xw2519/EE-Mars-Rover/src/Control/Esp32_Client.ino

/*
    Esp32 Websockets Client

    This sketch:
        1. Connects to a WiFi network
        2. Connects to a Websockets server
        3. Sends the websockets server a message ("Hello Server")
        4. Prints all incoming messages while the connection is open

    Hardware:
        For this sketch you only need an ESP32 board.

    Created 15/02/2019
    By Gil Maimon
    https://github.com/gilmaimon/ArduinoWebsockets

*/

#include <ArduinoWebsockets.h>
#include <WiFi.h>

const char* ssid = ""; //Enter SSID
const char* password = ""; //Enter Password
const char* websockets_server_host = "18.219.193.128"; //Enter server adress
const uint16_t websockets_server_port = 8000; // Enter server port
bool auto_mode = false;
using namespace websockets;

String dataFromDrive;
String dataFromVision;
String dataToCommand;
char currentInstruction;
float total_x=0;
float total_y=0;
float total_angle=0; //Angle 0 means North. Going clockwise, so 90 is East.
float distance=0;

struct Ball{
  char colour;
  float x;
  float y;
};

Ball balls[10];

WebsocketsClient client;

String readNCharsPort1(int n){ //This code is meant to read n chars from the Serial1 port.
String result = "";
  for(int i =0;(i<n && Serial1.available());i++){
    result += String((char)Serial1.read());
  }
  return result;
}

void sendBallToCommand(char colour,float x,float y){
  dataToCommand = "{\"type\":\"Map\",\"x_distance\":\"" + String(x) + "\",\"y_distance\":\"" + String(-y) + "\",\"color\":\""+String(colour)+"\",\"map_type\":\"Obstacle\"}";
      client.send(dataToCommand);


}

void setup(){
  Serial.begin(115200);
  Serial1.begin(115200, SERIAL_8N1,23,22); // Vision
  Serial2.begin(115200, SERIAL_8N1,16,17); //Drive
  // Connect to wifi
  WiFi.begin(ssid, password);

  // Wait some time to connect to wifi
  for(int i = 0; i < 10 && WiFi.status() != WL_CONNECTED; i++){
    Serial.print(".");
    delay(1000);
  }

  // Check if connected to wifi
  if(WiFi.status() != WL_CONNECTED) {
    Serial.println("No Wifi!");
    return;
  }

  Serial.println("Connected to Wifi, Connecting to server.");
  // try to connect to Websockets server
  while(!client.connect(websockets_server_host, websockets_server_port, "/ws/rover")){ Serial.print(".");delay(100); }

  Serial.println("Connected!");
  client.send("Hello Server");

  // run callback when messages are received
  client.onMessage([&](WebsocketsMessage message){
    Serial.println(message.data());
    if(message.data()=="Automode"){
      auto_mode = true;
    }else{
    currentInstruction=message.data()[0]; Serial.println(currentInstruction);
      Serial.println("Sending to Drive");
      Serial2.print(message.data());
      if(message.data()[0]!= 'S') { Serial1.write('m'); }
      else { Serial1.write('s'); }
    }
  });
}

bool know_pos=0, stop_reasoned=0;
char last_command='c';

void loop() {
  client.ping();
  delay(100);
  if(client.available()){
    client.poll();
  }else{
    Serial.println("client not available");while(!client.connect(websockets_server_host, websockets_server_port, "/ws/rover")){Serial.print(".");delay(100);}
  }

  if(Serial2.available()){
    Serial.print("Received from Drive: ");
    dataFromDrive = Serial2.readString();
    Serial.println(dataFromDrive);
    if(dataFromDrive[0] == 'p'){

    }else{
      Serial1.write('s');
      distance=atof(dataFromDrive.substring(3).c_str());

      if(dataFromDrive[0]=='F' || dataFromDrive[0]=='B'){
        total_y += (distance * cos(3.14159265*total_angle/180.0));
        total_x += (distance * sin(3.14159265*total_angle/180.0));
        know_pos = 1;
      }
      if(dataFromDrive[0]=='L' || dataFromDrive[0]=='R'){
        total_angle = (total_angle + distance) -(360*int(int((total_angle + distance))/360));
      }
      if(dataFromDrive[1]=='0'){client.send("{\"type\":\"Terminal\",\"message\":\"Instruction not completed\"}");}
      dataToCommand = "{\"type\":\"Map\",\"x_distance\":\"" + String(total_x) + "\",\"y_distance\":\"" + String(-total_y) + "\",\"angle\":\""+String(total_angle)+"\",\"map_type\":\"Rover\"}";
      client.send(dataToCommand);
    currentInstruction='S';
    }
  }

  if(Serial1.available()){

    dataFromVision = Serial1.readString();
    //Serial.println(dataFromVision);

    if(dataFromVision[0]=='s' && currentInstruction=='F'){
      Serial2.write('X');
      know_pos = 0;
      last_command = 's';
      stop_reasoned = 0;

    }else if(dataFromVision[0]=='p'){ //Vision tells control to pause
      last_command = 'p';

      Serial2.write('P'); //Control tells drive to Pause

      while(!Serial2.available() || Serial2.peek()!='p'){ //Waits until drive has paused and confirms
        delay(1);
      }
      Serial2.read();
      delay(100);
      total_x += atof(Serial2.readString().c_str());

      Serial2.write('X');
      while(!Serial2.available() || Serial2.peek()!='y'){ //Waits until drive has paused and confirms
        delay(1);
      }
      Serial2.read();
      delay(100);
      total_y += atof(Serial2.readString().c_str());

      Serial1.write('s'); //Control tells vision that it has stopped moving
    }

    if((last_command=='s')&&know_pos&&(!stop_reasoned)){
      while(Serial1.available()&&(!Serial1.peek()=='b')){
        Serial.print("Discarded: ");
        Serial.println(Serial1.read());
      }
      while(Serial1.available() < 7){//Length of ball message (e.g. bY45+05) is 7 characters
        delay(1);
        if(Serial1.available()&&(!Serial1.peek()=='b')){
          Serial.print("Discarded: ");
          Serial.println(Serial1.read());
        }
      }

      dataFromVision=readNCharsPort1(7);
      Serial.println(dataFromVision);
      float ball_x=total_x;
      float ball_y=total_y;
      float perp_distance = dataFromVision.substring(2,4).toFloat();
      float other_distance= atof(dataFromVision.substring(4).c_str());
      float total_distance = sqrt(perp_distance*perp_distance + other_distance*other_distance);
      float relative_angle = total_angle+(180.0*atan(other_distance/perp_distance)/3.14159265);
      ball_x += (total_distance*sin(3.14159265*(relative_angle)/180.0));
      ball_y += (total_distance*cos(3.14159265*(relative_angle)/180.0));

      dataToCommand = "{\"type\":\"Terminal\",\"message\":\"Emergency stop due to ball  .\"}";
      client.send(dataToCommand);
      sendBallToCommand(dataFromVision[1],ball_x,ball_y);
      switch(dataFromVision[1]){
        case 'R':
          balls[0] = Ball{'R',ball_x,ball_y};
          break;
        case 'P':
          balls[1] = Ball{'P',ball_x,ball_y};
          break;
        case 'Y':
          balls[2] = Ball{'Y',ball_x,ball_y};
          break;
        case 'G':
          balls[3] = Ball{'G',ball_x,ball_y};
          break;
        case 'B':
          balls[4] = Ball{'B',ball_x,ball_y};
          break;
        case 'U':
          balls[5] = Ball{'U',ball_x,ball_y};
          break;
      }
      while(Serial1.available()){Serial1.read();} //Flushes the buffer, used to remove any extra ball messages that were sent by vision
      Serial1.write('a');
      Serial1.flush(); //Waits until 'a' was actually sent
    }

    if((dataFromVision[0]=='p')||((dataFromVision[0]=='s')&&know_pos&&stop_reasoned)){
      while(!Serial1.available() || Serial1.peek()!='c'){

        while(Serial1.available() < 7){//Length of ball message (e.g. bY45+05) is 7 characters
          if(Serial1.peek() == 'c'){ break; }
          delay(1);
          if(Serial1.available()&&(!((Serial1.peek()=='b')||(Serial1.peek()=='c')))){
            Serial.print("Discarded: ");
            Serial.println(Serial1.read());
          }
        }

        if(Serial1.peek() == 'c'){
          Serial1.read();
          break;
        }

        dataFromVision=readNCharsPort1(7);
        Serial.println(dataFromVision);
        float ball_x=total_x;
        float ball_y=total_y;
        float perp_distance = dataFromVision.substring(2,4).toFloat();
        float other_distance= atof(dataFromVision.substring(4).c_str());
        float total_distance = sqrt(perp_distance*perp_distance + other_distance*other_distance);
        float relative_angle = total_angle+(180.0*atan(other_distance/perp_distance)/3.14159265);
        ball_x += (total_distance*sin(3.14159265*(relative_angle)/180.0));
        ball_y += (total_distance*cos(3.14159265*(relative_angle)/180.0));
        sendBallToCommand(dataFromVision[1],ball_x,ball_y);
        switch(dataFromVision[1]){
          case 'R':
            balls[0] = Ball{'R',ball_x,ball_y};
            break;
          case 'P':
            balls[1] = Ball{'P',ball_x,ball_y};
            break;
          case 'Y':
            balls[2] = Ball{'Y',ball_x,ball_y};
            break;
          case 'G':
            balls[3] = Ball{'G',ball_x,ball_y};
            break;
          case 'B':
            balls[4] = Ball{'B',ball_x,ball_y};
            break;
          case 'U':
            balls[5] = Ball{'U',ball_x,ball_y};
            break;
        }
        if(!Serial1.available() || (Serial1.peek() != 'c')){ //I think this if statement is needed if we avoid sending 'a' if vision has sent c. Otherwise, always do Serial1.write('a');
          while(Serial1.available()){Serial1.read();} //Flushes the buffer, used to remove any extra ball messages that were sent by vision
          Serial1.write('a');
          Serial1.flush(); //Waits until 'a' was actually sent

        }
      }
      delay(1);
      Serial.println("Received C from Vision");
      if(last_command=='p'){ Serial2.write('U'); }
      last_command = 'c';
      delay(50);
      while(Serial1.available()){Serial1.read();} //Flushes any more messages sent before 'm' sent
      Serial1.write('m'); //Tells vision that we're moving
    }

}
  delay(50);
}
