xw2519/EE-Mars-Rover/(commit log)

2021-05-18 Uploaded vision project with uart over IO pins 0 and 1
    [DE10_LITE_D8M_VIP.smp_dump.txt]
2021-05-24 Filters work at similar brightness level, could make automatic gain adjustment
2021-05-25 Tried to fix red filter
    [EEE_IMGPROC.v, Qsys_sysid_qsys.v, main.c, system.h]
2021-05-26 Automated gain calibration
2021-06-08 Cleaned master
    [DE10_LITE_D8M_VIP.smp_dump.txt]
2021-06-17 cleaned up repo
    [MarsRover2021PM_Group18.xlsx]
